TuanDanny/AW-Car/docs/README.md

# Tài liệu simplev1

- [Bản source ba board hiện hành](current-release.md).

- [Protocol](protocol.md): giao thức UART/SPI và hành vi điều khiển.
- [Nguồn tham khảo](upstream.md), [Brain](brain.md), [Dashboard](dashboard.md).
- [Build/nạp/log](build.md), [kết quả kiểm chứng](verification.md).
- [Mốc skeleton đã duyệt](skeleton-baseline.md), [câu nói/pinyin/dịch nghĩa](voice-commands.md).
- [AP+STA / OTA đã duyệt và cổng kiểm thử](ota-network-plan.md).
- [Dùng OTA và log hằng ngày](ota-usage.md).
- [Đo độ trễ bốn nút trên điện thoại](latency-measurement.md).
- [Kết quả92mẫu thật và giới hạn SPI](latency-results.md).
- [Review tối ưu, chưa thay firmware](optimization-review.md).
- [Bản tối ưu nhỏ và số đo A/B sau nạp Motion](optimization-results.md).
