TuanDanny/AW-Car/.github/README.md

# Automation

CI cho nhánh simplev1 độc lập. Gowin có giấy phép và thử board chạy trên máy local.
