TuanDanny/AW-Car/esp/README.md

# ESP32-S3 simplev1

`brain`: Xiaozhi/âm thanh/OLED, STA-only. `motion`: AP/Web, điều khiển và SPI.
`shared`: C++17 không phụ thuộc ESP-IDF, codec/lõi điều khiển kiểm trên host.
