TuanDanny/AW-Car/dashboard/README.md

# Web Dashboard

Dashboard HTML/CSS/ES modules thuần, cùng asset trên ESP32 và PC simulator.
Manual/AI, Cho phép/DỪNG/Xóa lỗi, sáu hướng, tốc độ, transcript/tool events và
telemetry có cờ hợp lệ. Không CDN/framework hoặc JSON đi thẳng xuống FPGA.
Contract: [Web-v1](web-brain-protocol.md).

## Dùng dashboard trên điện thoại

1. Nối Wi-Fi `AW-CAR`, mở `http://192.168.4.1` bằng Chrome hoặc Safari. Nhập PIN hiện
   trên OLED; giữ BOOT lâu để hiện lại. PIN dashboard khác mật khẩu Wi-Fi,
   đổi sau mỗi reset. Chỉ giữ một tab dashboard đang kết nối.
2. WS2812 onboard chỉ báo trạng thái; cụm điều khiển đèn và tool RGB demo
   đã xóa. Nút **Bắt đầu/kết thúc nghe** tương đương nhấn/nhả BOOT ngắn.
   Đợi trạng thái đang nghe rồi nói tiếng Trung; xem nhận dạng, trả lời và
   tool trong nhật ký. Ví dụ chào `你好`; tool xe còn phải đủ mode/quyền/context.
3. Manual dùng sáu nút giữ để lái, nhả về 0; mức tốc độ mặc định 30%.
   Chỉ mở khi **Cho phép** đã được Motion xác nhận. Khi chưa nối Motion,
   các nút lái khóa và telemetry ghi “Chưa có dữ liệu”.
4. Chọn AI trên dashboard rồi xin phép Motion để nhận hành động xe ngắn.
   Manual vẫn trò chuyện và nhận DỪNG. Đổi mode, DỪNG hoặc mất liên
   kết an toàn sẽ thu quyền; phải Cho phép lại. Quyền AI tối đa 5 phút.
5. **Xóa lỗi** chỉ sáng khi Motion báo FAULT còn mới và chưa có quyền chạy.
   Sau khi nguyên nhân đã hết, bấm để yêu cầu phục hồi; thành công vẫn phải
   **Cho phép** lại. Không nhả E-stop rồi tự ARM. Chưa ghép gate/motor thật.
6. Để Safari ở trước màn hình khi điều khiển Manual. Ẩn tab/khóa màn hình
   hoặc mất Web sẽ dừng và bỏ ARM. Reconnect không phát lại nút đang giữ.

Ngày03/11 đã thử thực trên iPhone Safari: đăng nhập và giữ WebSocket ổn định,
RGB và nút nghe trên dashboard được người dùng xác nhận hoạt động.
Chưa nghiệm thu lái xe vì chưa có Motion/gate/motor trong vòng thử này.

## Chạy giả lập

Từ root: Python3.13, Node và compiler host C++17 (`g++`/`clang++` hoặc `CXX`).
Windows có thể dùng LLVM-MinGW chính thức trong `build/toolchain/`; không
dùng cross-compiler Xtensa để tạo chương trình chạy trên PC.

```powershell
python -m venv .venv
.venv/Scripts/python.exe -m pip install -r dashboard/requirements-dev.lock
python tools/build_brain_host.py
.venv/Scripts/python.exe dashboard/simulator.py --port 8767
```

Lockfile dev chốt Python3.13 và các phiên bản đã kiểm thử trong review tích hợp;
aiohttp3.14.5 thay3.13.2 có advisory đã công bố. Đây là server/test PC, không
phải dependency runtime ESP32. Nâng lock phải audit và chạy lại Web regression.

Mở `http://127.0.0.1:8767`, mã **123456 chỉ cho simulator localhost**.
Firmware dùng SSID `AW-CAR`; mật khẩu AP giữ trong NVS hoặc đặt cố định
bằng `CONFIG_AWCAR_AP_PASSWORD` ở sdkconfig cục bộ. PIN dashboard vẫn sinh
mỗi boot; không dùng credentials simulator cho ESP32. Simulator không mô phỏng CPU, Wi-Fi/I²S/
FreeRTOS, PID, FPGA hay motor. Mỗi instance chỉ nhận một WebSocket.

```powershell
.venv/Scripts/python.exe -m unittest discover -s tests
node --test dashboard/control.test.mjs dashboard/connection.test.mjs
```

Thử tải bằng instance riêng, không giành kết nối với trình duyệt:

```powershell
.venv/Scripts/python.exe dashboard/simulator.py --port 8768
.venv/Scripts/python.exe tools/brain_soak.py --url http://127.0.0.1:8768 --seconds 1800 --report build/brain/soak.json
```

`/api/lab` chỉ có trong simulator để tiêm voice/mất mạng/tiến thời gian;
không có trong firmware. Soak dùng thời gian thực; test hạn5phút dùng đồng
hồ ảo riêng, không trộn thành số đo độ trễ thật. Trace Motion giữ256 frame,
sự kiện100, mẫu benchmark tối đa40.000.

## Brain thật + Motion PC test peer

Sau khi có bộ USB–UART **TTL3,3V**, nối Brain TX17→RX adapter,
RX18←TX adapter, GND chung. Không nối5V hoặc ngõ RS232 vào GPIO.
Giữ console/USB Brain riêng, chưa nối driver/motor.

```powershell
.venv/Scripts/python.exe tools/motion_serial_peer.py --port COM_ADAPTER
```

Peer chỉ xác thực BM-v1/lease, số đo tốc độ/pin invalid. Profile mặc định
`AWCAR_MOTION_IS_SIMULATED=y` để ghi nhãn giả lập. Brain đã được nạp ngày
03/11/2026, kiểm tra boot/AP+STA; chưa thử UART vật lý hoặc peer Motion.
Xem [bằng chứng](../docs/brain-dashboard-verification.md).

## Bổ sung ghép Motion 0.1

Core Motion mới ở `codex/esp32-s3-motion`, không thay PC peer mặc định ở đây.
Motion bản COM7 vẫn LOCKED; ngày04/11 đã ghép UART thật MotionTX13/RX14
với BrainRX18/TX17, chưa ghép FPGA/gate/motor. STATUS đo lại20,1Hz/age≤49ms;
không dùng Cho phép như bằng chứng motor sẽ chạy. Cấu hình
`AWCAR_MOTION_IS_SIMULATED` chỉ bỏ nhãn sau khi đã ghép và xác nhận dữ liệu
thật; profile đã nạp dùng `n`, mặc định PC peer vẫn `y`.
Xem [báo cáo UART hiện tại](../docs/brain-motion-final-link-report.json).
Computer use đã thử Xóa lỗi, giao diện hẹp và socket đóng; xem
[báo cáo bổ sung](../docs/brain-motion-clear-verification.md).

## Mốc 04/11: giao diện và chẩn đoán

Màn hình chính tập trung vào mode, Cho phép/DỪNG, hướng và tốc độ. Mở
Trạng thái xe/RGB/Trợ lý/Wi-Fi khi cần; AI tự mở hội thoại. Chẩn đoán mạng
nằm trong mục mở rộng. Không bỏ chức năng hoặc thay contract an toàn.
`connection.mjs` tách trạng thái kết nối/quyền cục bộ để test không cần DOM.
Simulator có `pause_status` (0–10.000 ms) và bộ đếm STOP chỉ để thử trạng
thái Degraded; không có endpoint này trên firmware.
Xem [báo cáo, phép đo và giới hạn phần cứng](../docs/brain-network-reliability.md).

## WS2812 báo trạng thái

Đã xóa UI/handler RGB thử nghiệm; không có lớp tương thích cho command đó.
`indicator` trong chẩn đoán là dữ liệu chỉ đọc: color/reason/known và bộ đếm
ghi/lỗi LED. Simulator cũng dùng policy C++ sản xuất, không tự dựng bộ chọn
màu bằng Python. Nút nghe, Manual/AI, sáu hướng và STOP giữ nguyên.
Xem [contract LED](../docs/status-led.md).

Trong mục Wi-Fi, badge xác nhận trạng thái STA thực (khởi tạo/kết nối/DHCP/
đã cóIP/thử lại), IP/RSSI và lý do lỗi/countdown khi có. Trạng thái Xiaozhi
được tách riêng: nối Wi-Fi chưa chứng minh cloud đã nối. Khi mất STATUS/WS,
giao diện không giữ nhãn xanh cũ. Lưu cấu hình chỉ báo đã nhận yêu cầu; chờ
STATUS xác nhận. Mạng được chọn làm mặc định cho lần boot sau kể cả đã lưu
ở vị trí khác; không phải chỉ cập nhật mật khẩu rồi vẫn chọn mạng cũ.
