TuanDanny/AW-Car/esp/shared/README.md

# Lõi dùng chung

Contract ở `../../docs/protocol.md`. Code C++17, không driver/FreeRTOS/heap trên
đường điều khiển. Hai firmware include thư mục này; host test dùng cùng source.
