TuanDanny/AW-Car/fpga/targets/README.md

# Target board

[Tang Nano9K](tang_nano9k/README.md) là target simplev1 duy nhất: shell POR,
CST, SDC và Tcl build bằng Gowin. RTL chức năng dùng chung ở `../rtl`.
