TuanDanny/AW-Car/esp/brain/main/README.md

# Brain application

Application Xiaozhi v2.5.2 được giữ cho activation, audio và giao thức cloud.
Profile cố định ở `boards/aw-car`; UART/MCP context ở `car`. CMake liệt kê
tường minh các nguồn cần dùng; không quét hay nhập các board upstream khác.
