TuanDanny/AW-Car/esp/shared/src/README.md

# Implementation

Codec và Control dùng chung giữa ESP32 và host simulator/test, không cấp phát heap.
