TuanDanny/AW-Car/esp/brain/main/boards/README.md

# Board cố định

Chỉ `aw-car` được build. `common` giữ interface Board và BOOT upstream;
không có bộ chọn hàng trăm board hoặc modem.
