TuanDanny/AW-Car/esp/brain/main/display/README.md

# OLED display

Chỉ SSD1306 128×64/LVGL; giữ font Trung và dynamic glyph upstream.
Không nhập LCD màu, e-paper, JPEG, GIF hoặc assets board khác.
