TuanDanny/AW-Car/esp/brain/main/led/README.md

# LED interface

Interface Led upstream; pixel WS2812 thật nằm ở `boards/aw-car/status_led`.
Không đăng ký tool RGB.
