TuanDanny/AW-Car/esp/shared/include/simple/README.md

# API C++

`protocol.hpp`: UART/SPI và các kiểu dùng chung. `control.hpp`: phân xử Manual/AI,
deadline, đổi chiều và wake driver. Một task sở hữu, thời gian truyền từ caller.
