TuanDanny/AW-Car/firmware/brain/docs/v0/README.md

# Xiaozhi: docs/v0

Thành phần từ Xiaozhi v2.5.2, commit 49b4380b3faa0ceadd28a3e78aaf0f311c46c57e.
Giữ để build và đối chiếu bản stock; phần cứng AW-Car chưa nghiệm thu.

Nội dung trực tiếp trong thư mục:

- `AtomMatrix-echo-base.jpg`
- `atoms3r-echo-base.jpg`
- `ESP32-BreadBoard.jpg`
- `esp32s3-box3.jpg`
- `lichuang-s3.jpg`
- `m5stack-cores3.jpg`
- `magiclick-2p4.jpg`
- `waveshare-esp32-s3-touch-amoled-1.8.jpg`
- `wiring.jpg`
