TuanDanny/AW-Car/firmware/brain/main/boards/README.md

# Xiaozhi: main/boards

Thành phần từ Xiaozhi v2.5.2, commit 49b4380b3faa0ceadd28a3e78aaf0f311c46c57e.
Giữ để build và đối chiếu bản stock; phần cứng AW-Car chưa nghiệm thu.

Nội dung trực tiếp trong thư mục:

- [aw-car-ai-rgb](aw-car-ai-rgb/README.md): demo F03 điều khiển RGB qua MCP.
- `alientek/`
- `bread-compact-esp32/`
- `bread-compact-esp32-lcd/`
- `bread-compact-ml307/`
- `bread-compact-nt26/`
- `bread-compact-wifi/`
- `bread-compact-wifi-lcd/`
- `bread-compact-wifi-s3cam/`
- `chd/`
- `common/`
- `dfrobot/`
- `doit-s3-aibox/`
- `du-chatx/`
- `electron-bot/`
- `espressif/`
- `folotoy/`
- `freenove-esp32s3-display-2.8-lcd/`
- `genjutech-s3-1.54tft/`
- `guition/`
- `hu-087/`
- `jiuchuan-s3/`
- `kevin/`
- `labplus/`
- `lc-s3-wifi-1.54tft/`
- `lcdwiki-es3c35p/`
- `lceda-course-examples/`
- `lckfb/`
- `lilygo/`
- `m5stack/`
- `magiclick/`
- `maza-ai/`
- `minsi-k08-dual/`
- `mixgo-nova/`
- `movecall/`
- `nologo/`
- `nulllab-ai-vox-v3/`
- `otto-robot/`
- `quandong-s3-dev/`
- `rymcu/`
- `sensecap-watcher/`
- `spotpear/`
- `surfer-c3-1.14tft/`
- `taiji-pi-s3/`
- `waveshare/`
- `wdmomo/`
- `wk-esp32s3-dev/`
- `xmini/`
- `xorigin/`
- `yunliao-s3/`
- `zectrix/`
- `zhengchen/`
