TuanDanny/AW-Car/esp/brain/main/audio/codecs/README.md

# I²S codec

`NoAudioCodecSimplex` upstream điều khiển I²S thật, tách mic và loa.
Các codec I²C/board khác đã được bỏ.
