TuanDanny/AW-Car/esp/brain/main/audio/engines/README.md

# ESP-SR engine

Engine AFE stock Xiaozhi cho ESP32-S3, xử lý audio16kHz và VAD chuẩn.
Không thêm lớp phân xử VAD riêng cho xe.
