TuanDanny/AW-Car/esp/brain/main/boards/common/README.md

# Board interfaces

Interface Board, nút BOOT và các header interface phụ được giữ từ Xiaozhi
v2.5.2. Không build WifiBoard provisioning, modem, camera, pin hoặc PWM.
