TuanDanny/AW-Car/firmware/brain/main/boards/bread-compact-esp32/README.md

# 编译配置命令

**配置编译目标为 ESP32：**

```bash
idf.py set-target esp32
```

**打开 menuconfig：**

```bash
idf.py menuconfig
```

**选择板子：**

```
Xiaozhi Assistant -> Board Type -> 面包板 ESP32 DevKit
```

**编译：**

```bash
idf.py build
```
