TuanDanny/AW-Car/firmware/brain/main/boards/bread-compact-wifi-lcd/README.md

# Xiaozhi: main/boards/bread-compact-wifi-lcd

Thành phần từ Xiaozhi v2.5.2, commit 49b4380b3faa0ceadd28a3e78aaf0f311c46c57e.
Giữ để build và đối chiếu bản stock; phần cứng AW-Car chưa nghiệm thu.

Nội dung trực tiếp trong thư mục:

- `compact_wifi_board_lcd.cc`
- `config.h`
- `config.json`
