TuanDanny/AW-Car/firmware/brain/main/boards/surfer-c3-1.14tft/README.md

## Surfer-ESP32-C3 开发板

1、参考立创·实战派C3-ESP32C3开发板，修改了TFT屏幕背光引脚，增加ADC电池电量检测功能;
2、该开发板 flash 大小为 16MB，编译时注意选择默认的分区表。
