TuanDanny/AW-Car/firmware/brain/main/boards/zhengchen/README.md

# Xiaozhi: main/boards/zhengchen

Thành phần từ Xiaozhi v2.5.2, commit 49b4380b3faa0ceadd28a3e78aaf0f311c46c57e.
Giữ để build và đối chiếu bản stock; phần cứng AW-Car chưa nghiệm thu.

Nội dung trực tiếp trong thư mục:

- `1.54tft-ml307/`
- `1.54tft-wifi/`
- `cam/`
- `cam-ml307/`
