TuanDanny/AW-Car/firmware/brain/main/boards/zectrix/zectrix-s3-epaper-4.2/README.md

# Xiaozhi: main/boards/zectrix/zectrix-s3-epaper-4.2

Thành phần từ Xiaozhi v2.5.2, commit 49b4380b3faa0ceadd28a3e78aaf0f311c46c57e.
Giữ để build và đối chiếu bản stock; phần cứng AW-Car chưa nghiệm thu.

Nội dung trực tiếp trong thư mục:

- `board_power_bsp.cc`
- `board_power_bsp.h`
- `charge_status.cc`
- `charge_status.h`
- `config.h`
- `config.json`
- `custom_lcd_display.cc`
- `custom_lcd_display.h`
- `i2c_power_hook.cc`
- `rtc_pcf8563.cc`
- `rtc_pcf8563.h`
- `sleep_manager_compat.h`
- `zectrix-s3-epaper-4.2.cc`
- `zectrix_nfc.cc`
- `zectrix_nfc.h`
