TuanDanny/AW-Car/firmware/brain/main/boards/alientek/atk-dnesp32s3m-wifi/README.md

# Xiaozhi: main/boards/alientek/atk-dnesp32s3m-wifi

Thành phần từ Xiaozhi v2.5.2, commit 49b4380b3faa0ceadd28a3e78aaf0f311c46c57e.
Giữ để build và đối chiếu bản stock; phần cứng AW-Car chưa nghiệm thu.

Nội dung trực tiếp trong thư mục:

- `atk_dnesp32s3m.cc`
- `config.h`
- `config.json`
