TuanDanny/AW-Car/firmware/brain/main/boards/espressif/esp-sparkbot/README.md

# Xiaozhi: main/boards/espressif/esp-sparkbot

Thành phần từ Xiaozhi v2.5.2, commit 49b4380b3faa0ceadd28a3e78aaf0f311c46c57e.
Giữ để build và đối chiếu bản stock; phần cứng AW-Car chưa nghiệm thu.

Nội dung trực tiếp trong thư mục:

- `config.h`
- `config.json`
- `esp_sparkbot_board.cc`
