TuanDanny/AW-Car/firmware/brain/main/boards/espressif/esp32-s3-korvo-2-v3.0-rndis/README.md

# Xiaozhi: main/boards/espressif/esp32-s3-korvo-2-v3.0-rndis

Thành phần từ Xiaozhi v2.5.2, commit 49b4380b3faa0ceadd28a3e78aaf0f311c46c57e.
Giữ để build và đối chiếu bản stock; phần cứng AW-Car chưa nghiệm thu.

Nội dung trực tiếp trong thư mục:

- `config.h`
- `config.json`
- `esp32s3_korvo2_v3_board.cc`
- `power_manager.h`
