TuanDanny/AW-Car/firmware/brain/main/boards/m5stack/atommatrix-echo-base/README.md

# 编译配置命令

**配置编译目标为 ESP32：**

```bash
idf.py set-target esp32
```

**打开 menuconfig：**

```bash
idf.py menuconfig
```

**选择板子：**

```
Xiaozhi Assistant -> Board Type -> AtomMatrix + Echo Base
```

**编译：**

```bash
idf.py build
```
