TuanDanny/AW-Car/firmware/brain/main/boards/waveshare/esp32-p4-wifi6-touch-lcd-3.5/README.md

# Waveshare ESP32-P4-WIFI6-Touch-LCD-3.5

**ESP32-P4-WIFI6-Touch-LCD-3.5** is the ESP32-P4 +ESP32-C6 screen development board launched by waveshare.

## Configuration

Configuration in `menuconfig`.

Selection Board Type `Xiaozhi Assistant --> Board Type`
- Waveshare ESP32-P4-WIFI6-Touch-LCD-3.5
