TuanDanny/AW-Car/firmware/brain/main/boards/waveshare/esp32-s3-cam/README.md

新增 微雪 开发板: ESP32-S3-CAM-XXXX
产品链接：
https://www.waveshare.net/shop/ESP32-S3-CAM-OV5640.htm
https://www.waveshare.net/shop/ESP32-S3-CAM-OV3660.htm
https://www.waveshare.net/shop/ESP32-S3-CAM-GC2145.htm
https://www.waveshare.net/shop/ESP32-S3-CAM-GC0308.htm
