TuanDanny/AW-Car/.githooks/README.md

# Hooks simplev1

Kiểm cấu trúc trước commit, kiểm native trước push. Không bỏ hook để che lỗi.
