TuanDanny/AW-Car/esp/brain/scripts/README.md

# Build assets

Hai script upstream: sinh header locale và đóng gói font/assets.
Không gọi flash, monitor hoặc cổng serial.
