TuanDanny/AW-Car/esp/shared/include/README.md

# Public headers

Thư mục `simple` chứa các kiểu/codec/lõi điều khiển không phụ thuộc SDK.
