TuanDanny/AW-Car/esp/brain/main/assets/README.md

# Built-in assets

Chỉ âm báo chung và tiếng Trung từ upstream. Font Trung được đóng gói
vào `generated_assets.bin` từ dependency xiaozhi-fonts đã khóa phiên bản.
`lang_config.h` là file sinh, không commit.
