TuanDanny/AW-Car/esp/brain/main/audio/README.md

# Stock audio pipeline

AudioService, Opus, I²S simplex và ESP-SR AFE của Xiaozhi v2.5.2. Chỉ
NoAudioCodecSimplex được dùng với INMP441/MAX98357A; tên upstream này
chỉ module I²S không có codec điều khiển, không phải âm thanh giả.
Không có CarChat/VAD guard bổ sung. Wake word không được bật trong profile.
