TuanDanny/AW-Car/esp/brain/main/notify/README.md

# Xiaozhi notifications

NotifyPlayer stock phát URL audio và subtitle qua AudioService. Không có
quyền điều khiển Motion.
