TuanDanny/AW-Car/esp/brain/main/assets/common/README.md

# Common sounds

Các âm báo Ogg upstream được Application/AudioService sử dụng.
