TuanDanny/AW-Car/esp/brain/main/assets/locales/README.md

# Locale

Chỉ giữ zh-CN cho profile được duyệt.
