TuanDanny/AW-Car/esp/brain/main/audio/demuxer/README.md

# Ogg audio

Ogg demuxer upstream phục vụ âm thanh activation/notification và gói Opus.
