TuanDanny/AW-Car/esp/brain/main/audio/wake_words/README.md

# Stock AFE support

Các lớp CustomWakeWord/cache được engine AFE upstream tham chiếu.
Profile không đóng gói mô hình WakeNet/MultiNet, không tự khởi động phiên lái.
