TuanDanny/AW-Car/esp/brain/main/display/lvgl_display/README.md

# LVGL text support

Font, theme tối, text/glyph cache và image interface mà OLED/Assets dùng.
Snapshot JPEG và điều khiển GUI từ cloud không bật trong profile.
