TuanDanny/AW-Car/firmware/brain/main/assets/locales/README.md

# Xiaozhi: main/assets/locales

Thành phần từ Xiaozhi v2.5.2, commit 49b4380b3faa0ceadd28a3e78aaf0f311c46c57e.
Giữ để build và đối chiếu bản stock; phần cứng AW-Car chưa nghiệm thu.

Nội dung trực tiếp trong thư mục:

- `ar-SA/`
- `bg-BG/`
- `ca-ES/`
- `cs-CZ/`
- `da-DK/`
- `de-DE/`
- `el-GR/`
- `en-US/`
- `es-ES/`
- `fa-IR/`
- `fi-FI/`
- `fil-PH/`
- `fr-FR/`
- `he-IL/`
- `hi-IN/`
- `hr-HR/`
- `hu-HU/`
- `id-ID/`
- `it-IT/`
- `ja-JP/`
- `ko-KR/`
- `mr-IN/`
- `ms-MY/`
- `nb-NO/`
- `nl-NL/`
- `pl-PL/`
- `pt-BR/`
- `pt-PT/`
- `ro-RO/`
- `ru-RU/`
- `sk-SK/`
- `sl-SI/`
- `sr-RS/`
- `sv-SE/`
- `th-TH/`
- `tr-TR/`
- `uk-UA/`
- `vi-VN/`
- `zh-CN/`
- `zh-TW/`
