TuanDanny/AW-Car/firmware/brain/main/audio/codecs/README.md

# Xiaozhi: main/audio/codecs

Thành phần từ Xiaozhi v2.5.2, commit 49b4380b3faa0ceadd28a3e78aaf0f311c46c57e.
Giữ để build và đối chiếu bản stock; phần cứng AW-Car chưa nghiệm thu.

Nội dung trực tiếp trong thư mục:

- `box_audio_codec.cc`
- `box_audio_codec.h`
- `dummy_audio_codec.cc`
- `dummy_audio_codec.h`
- `es8311_audio_codec.cc`
- `es8311_audio_codec.h`
- `es8374_audio_codec.cc`
- `es8374_audio_codec.h`
- `es8388_audio_codec.cc`
- `es8388_audio_codec.h`
- `es8389_audio_codec.cc`
- `es8389_audio_codec.h`
- `no_audio_codec.cc`
- `no_audio_codec.h`
