TuanDanny/AW-Car/esp/brain/main/assets/locales/zh-CN/README.md

# 简体中文

Bản dịch và âm thanh activation zh-CN từ Xiaozhi v2.5.2.
