TuanDanny/AW-Car/firmware/brain/main/assets/locales/bg-BG/README.md

# Xiaozhi: main/assets/locales/bg-BG

Thành phần từ Xiaozhi v2.5.2, commit 49b4380b3faa0ceadd28a3e78aaf0f311c46c57e.
Giữ để build và đối chiếu bản stock; phần cứng AW-Car chưa nghiệm thu.

Nội dung trực tiếp trong thư mục:

- `0.ogg`
- `1.ogg`
- `2.ogg`
- `3.ogg`
- `4.ogg`
- `5.ogg`
- `6.ogg`
- `7.ogg`
- `8.ogg`
- `9.ogg`
- `activation.ogg`
- `err_pin.ogg`
- `err_reg.ogg`
- `language.json`
- `upgrade.ogg`
- `welcome.ogg`
- `wificonfig.ogg`
