TuanDanny/AW-Car/docs/brain-dashboard-desktop.png

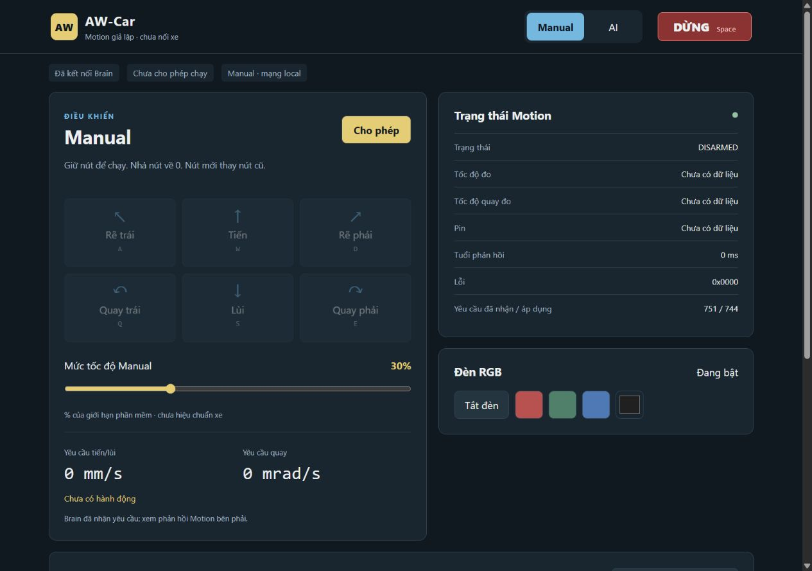
docs/brain-dashboard-desktop.png
