TuanDanny/AW-Car/docs/brain-network-degraded.png

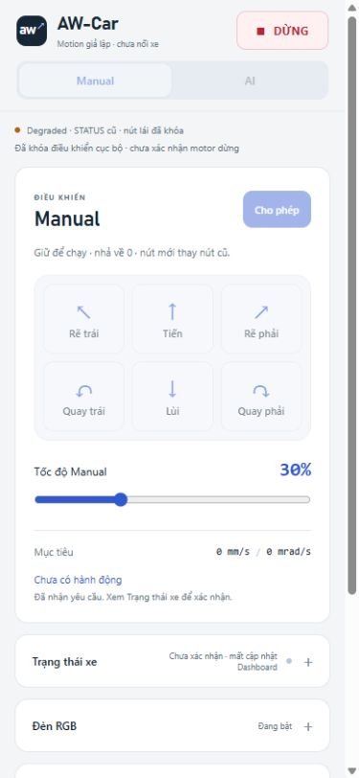
docs/brain-network-degraded.png
