TuanDanny/AW-Car/docs/status-led-dashboard.png

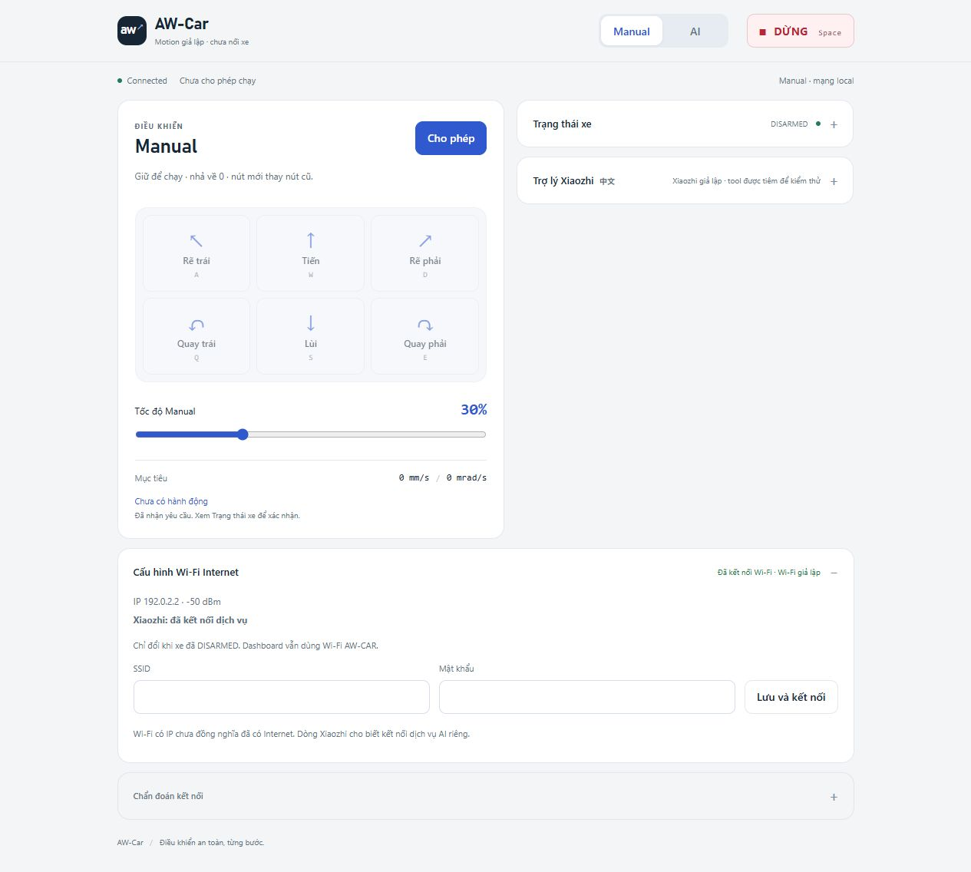
docs/status-led-dashboard.png
