TuanDanny/AW-Car/schematic/simplev1-preview.png

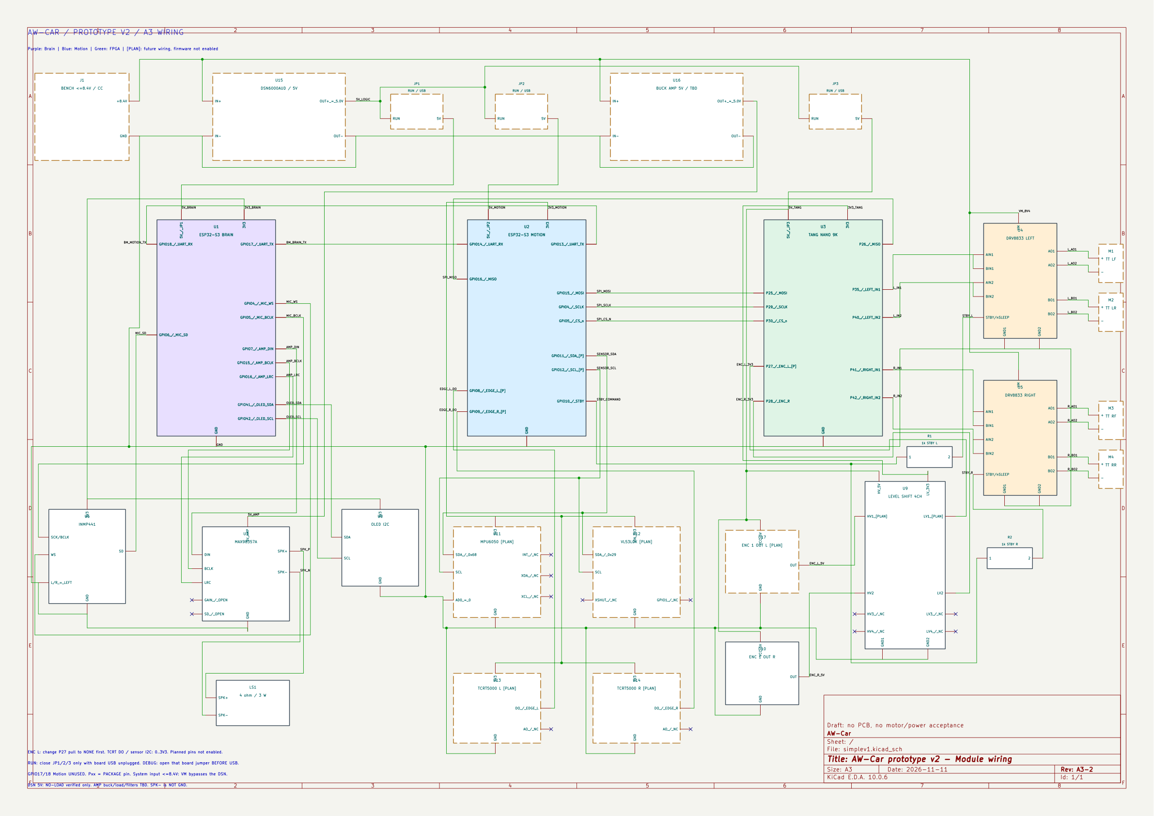
schematic/simplev1-preview.png
