TuanDanny/AW-Car/esp/brain/components/xiaozhi_network/README.md

# Xiaozhi ESP network transport

Phần ESP từ78/esp-ml3073.7.6, commit bf62ab3daf30965c18cde113e6c93df3cada6363
(Apache-2.0; giữ LICENSE). Chỉ HTTP client/TCP/TLS/MQTT/UDP/WebSocket;
không nhập AT modem/UART UHCI/cellular. MQTT registry được khóa trong manifest.
