TuanDanny/AW-Car/esp/brain/components/xiaozhi_network/src/README.md

# Network implementation

HTTP/WebSocket/NetworkError stock; transport socket ESP nằm trong `esp`.
