TuanDanny/AW-Car/esp/brain/components/xiaozhi_network/src/esp/README.md

# ESP socket transports

TLS dùng certificate bundle; HTTP/MQTT/UDP/WebSocket là triển khai thật từ
component đã được dùng trong baseline Brain. Không thêm HTTP server.
