TuanDanny/AW-Car/esp/brain/components/README.md

# Narrow third-party imports

`xiaozhi_network`: phần transport ESP/TLS từ78/esp-ml307, không modem.
`ssid_store`: SsidManager từ78/esp-wifi-connect, không AP/HTTP provisioning.
Mỗi phần giữ LICENSE; các dependency registry có lockfile và LICENSE riêng.
