TuanDanny/AW-Car/esp/brain/components/ssid_store/README.md

# SsidManager

Nhập từ78/esp-wifi-connect3.3.1 (MIT), giữ LICENSE. Dùng đúng namespace
`wifi` và keys ssid/password/channel, suffix1..9. Bổ sung kiểm tra lỗi lưu,
ưu tiên SSID vừa nhận; không xóa namespace activation hoặc cấu hình audio.
