TuanDanny/AW-Car/esp/brain/components/ssid_store/include/README.md

# SSID store interface

Header SsidManager upstream với AddSsid trả kết quả lưu NVS.
