TuanDanny/AW-Car/(list of files, drawings)

Other design files:
data/schematic-verification.json
