TuanDanny/AW-Car/schematic/simplev1.kicad_sch

## KiCad design schematic/simplev1.kicad_sch (2026-11-11)

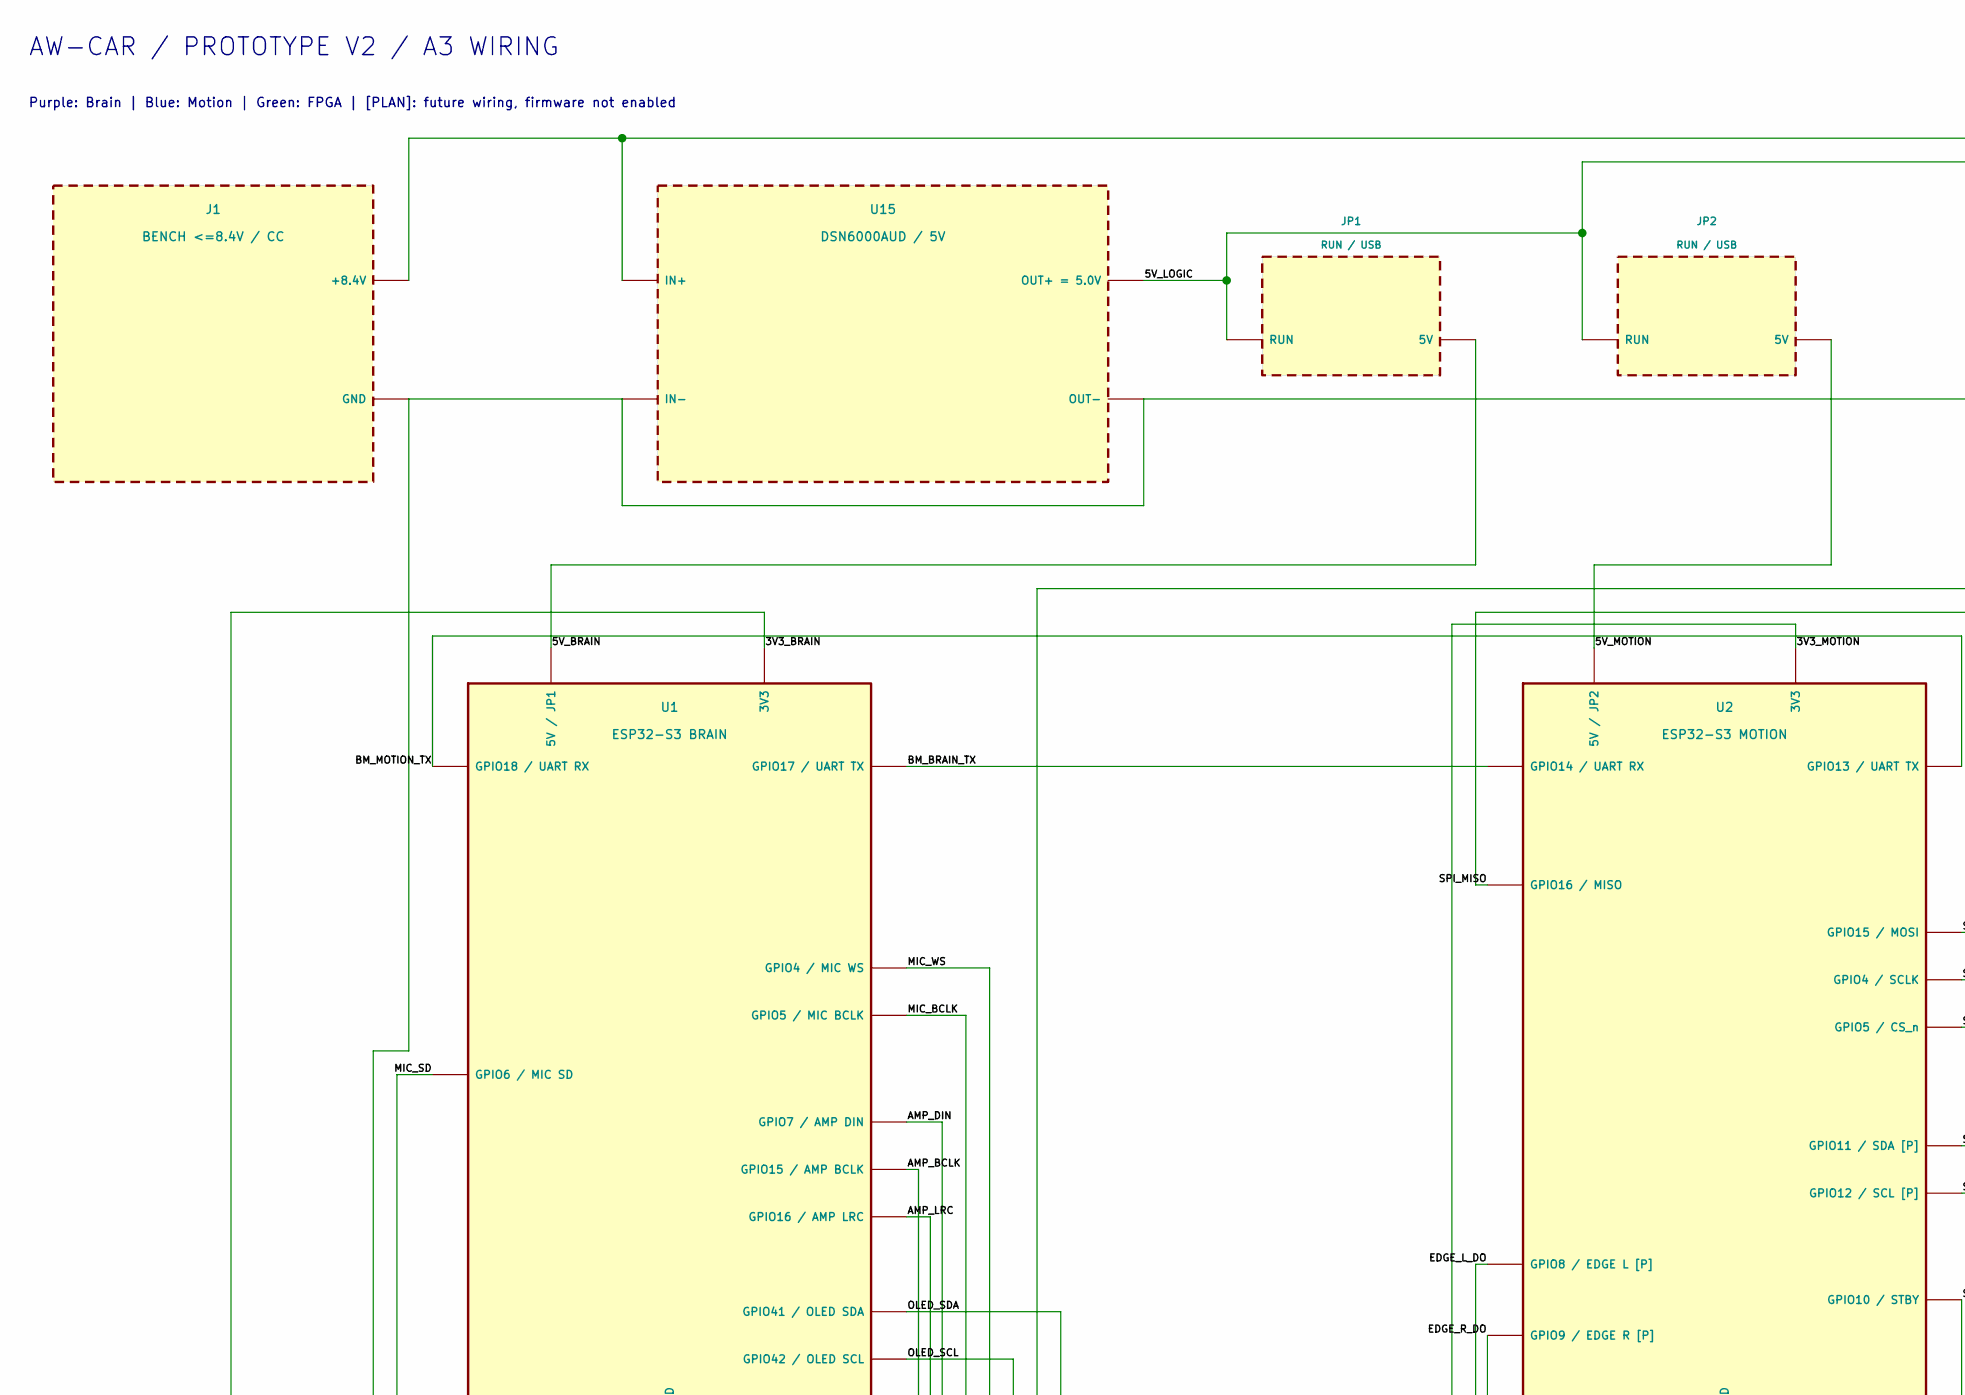
[picture p5: schematic simplev1.kicad_sch, part in row 1, column 1]

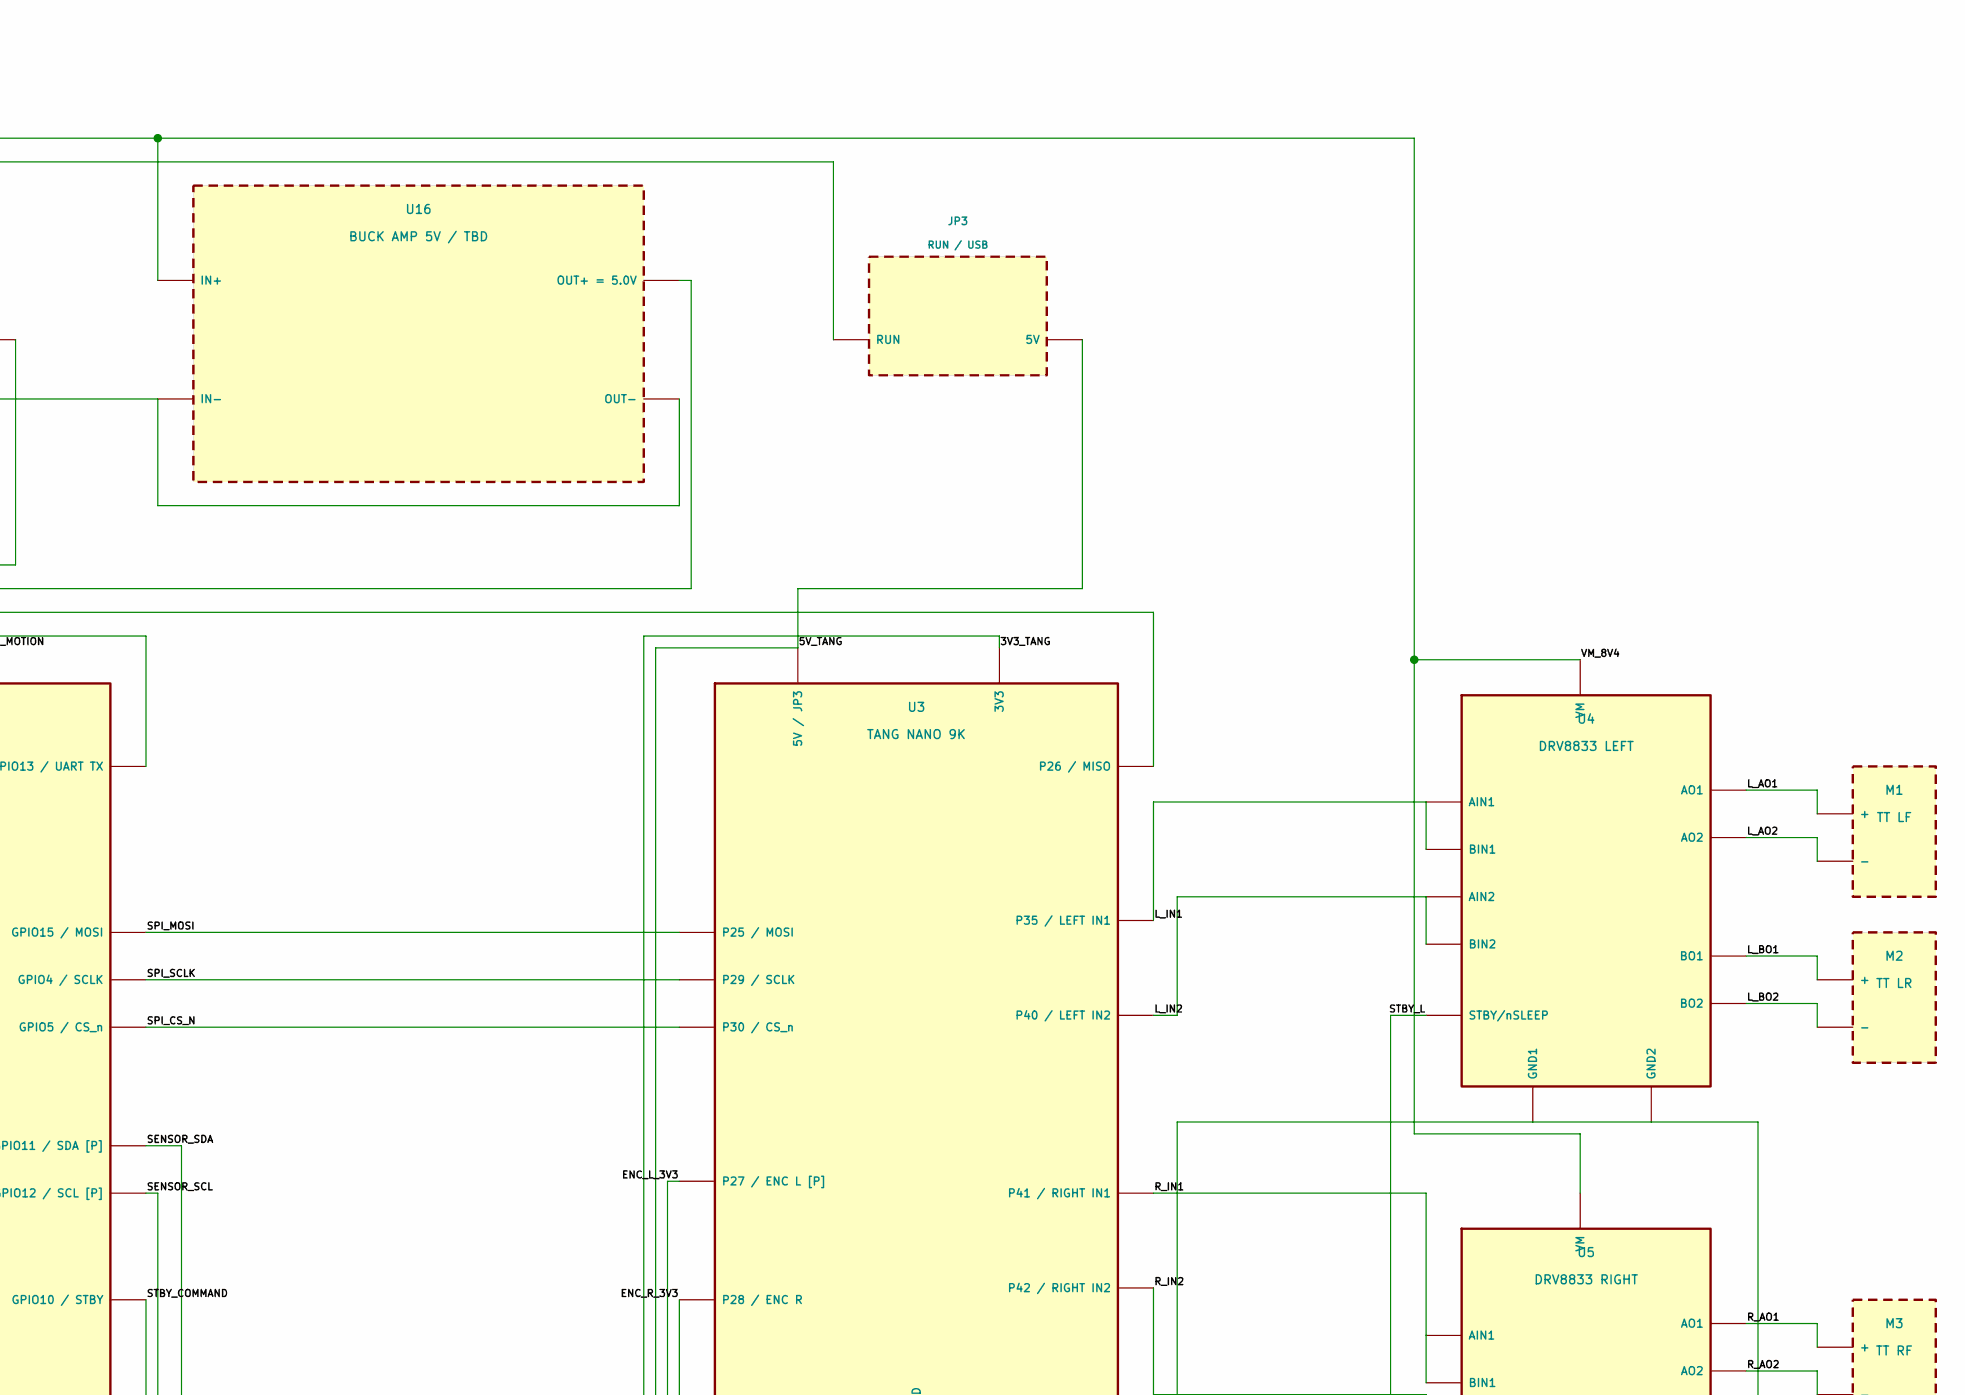
[picture p6: schematic simplev1.kicad_sch, part in row 1, column 2]

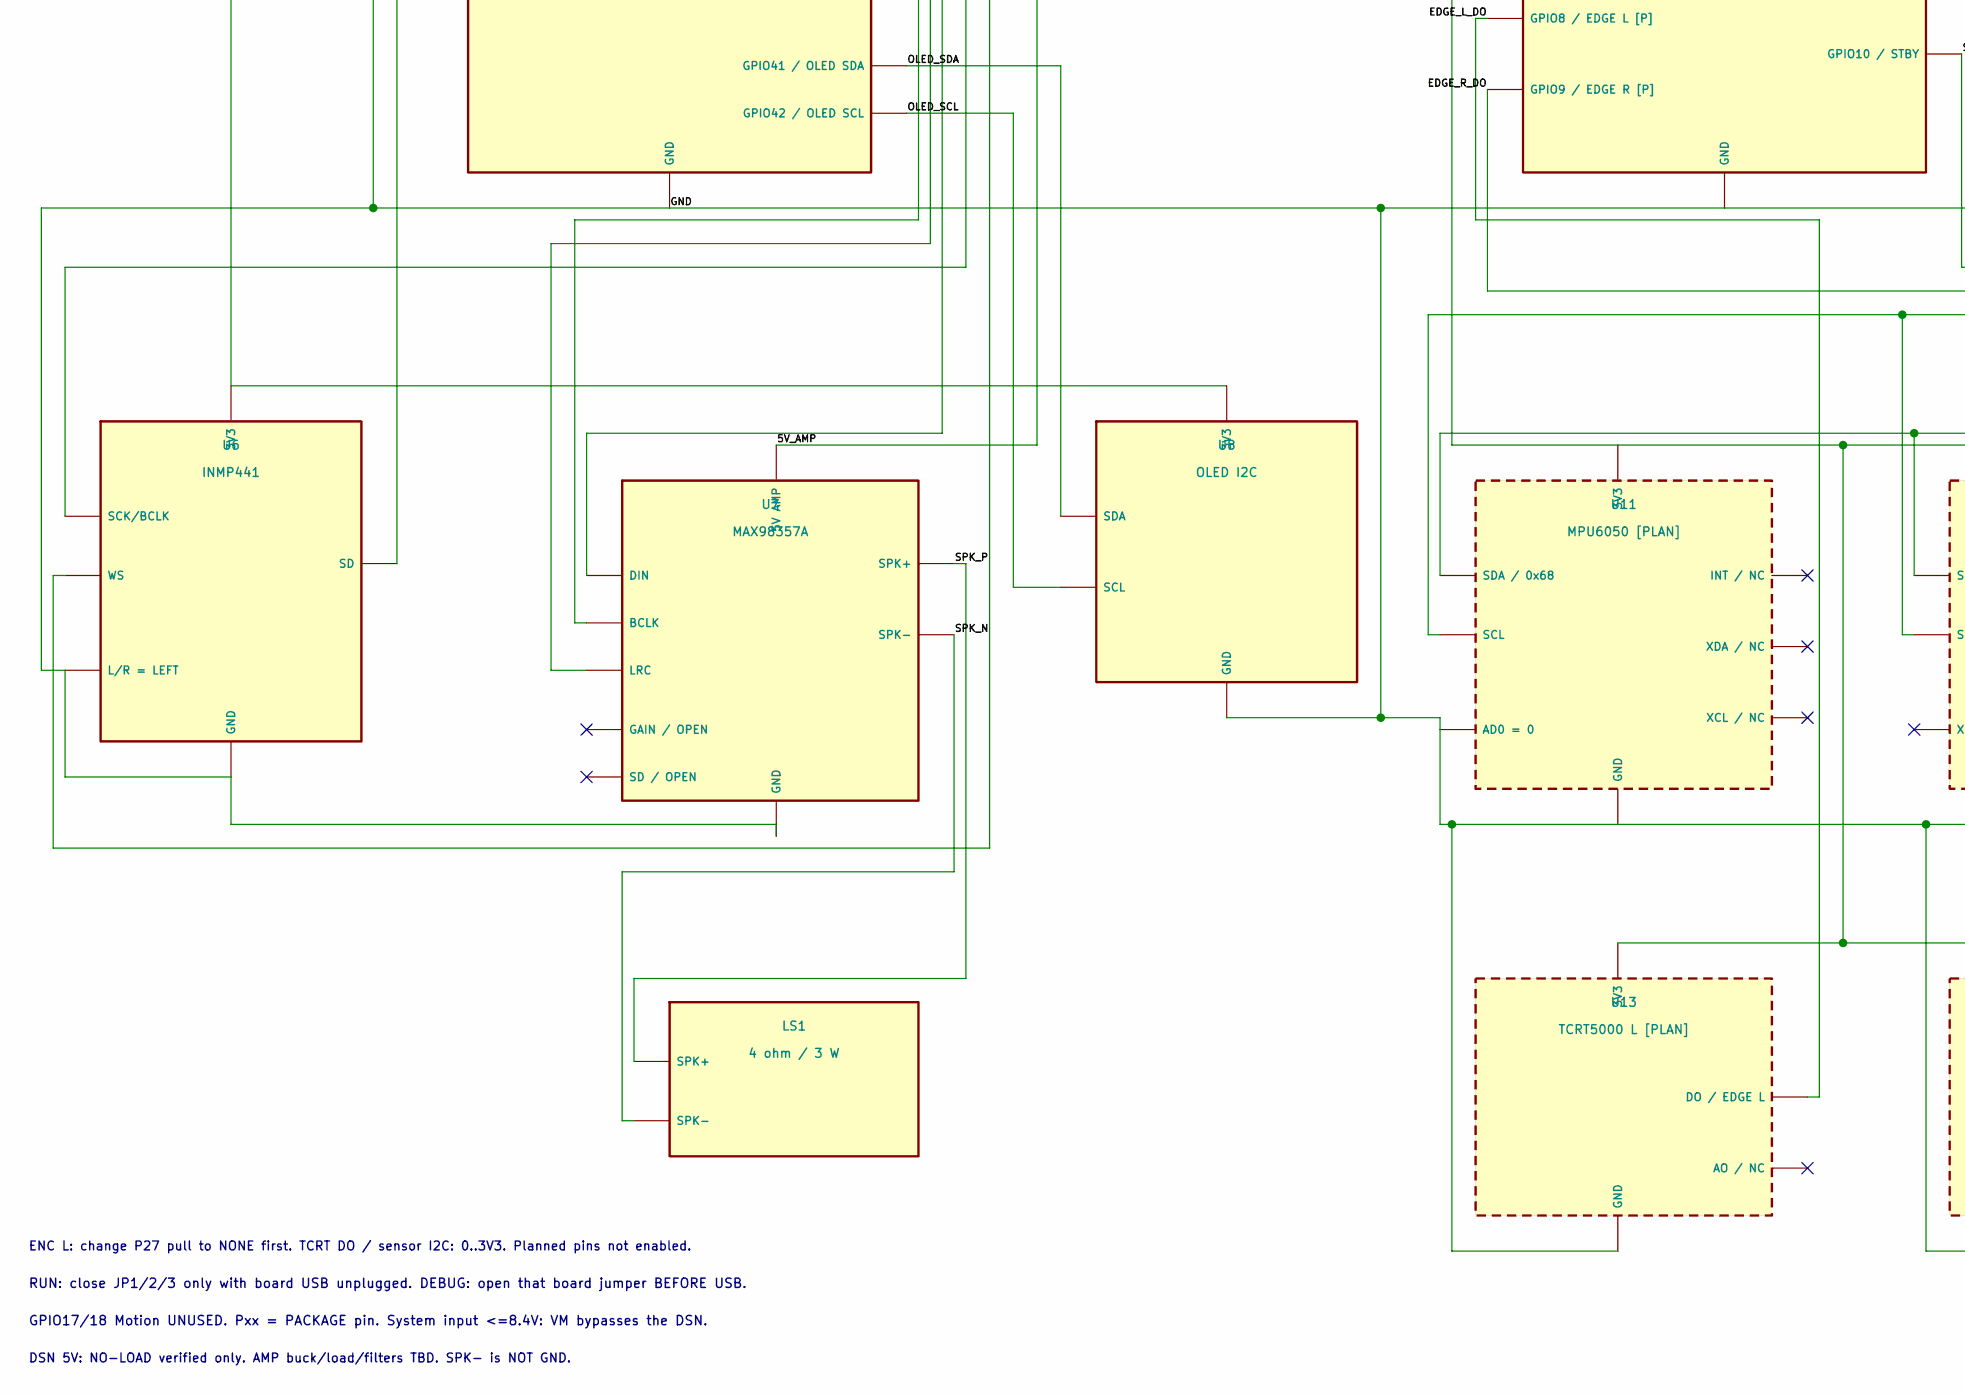
[picture p7: schematic simplev1.kicad_sch, part in row 2, column 1]

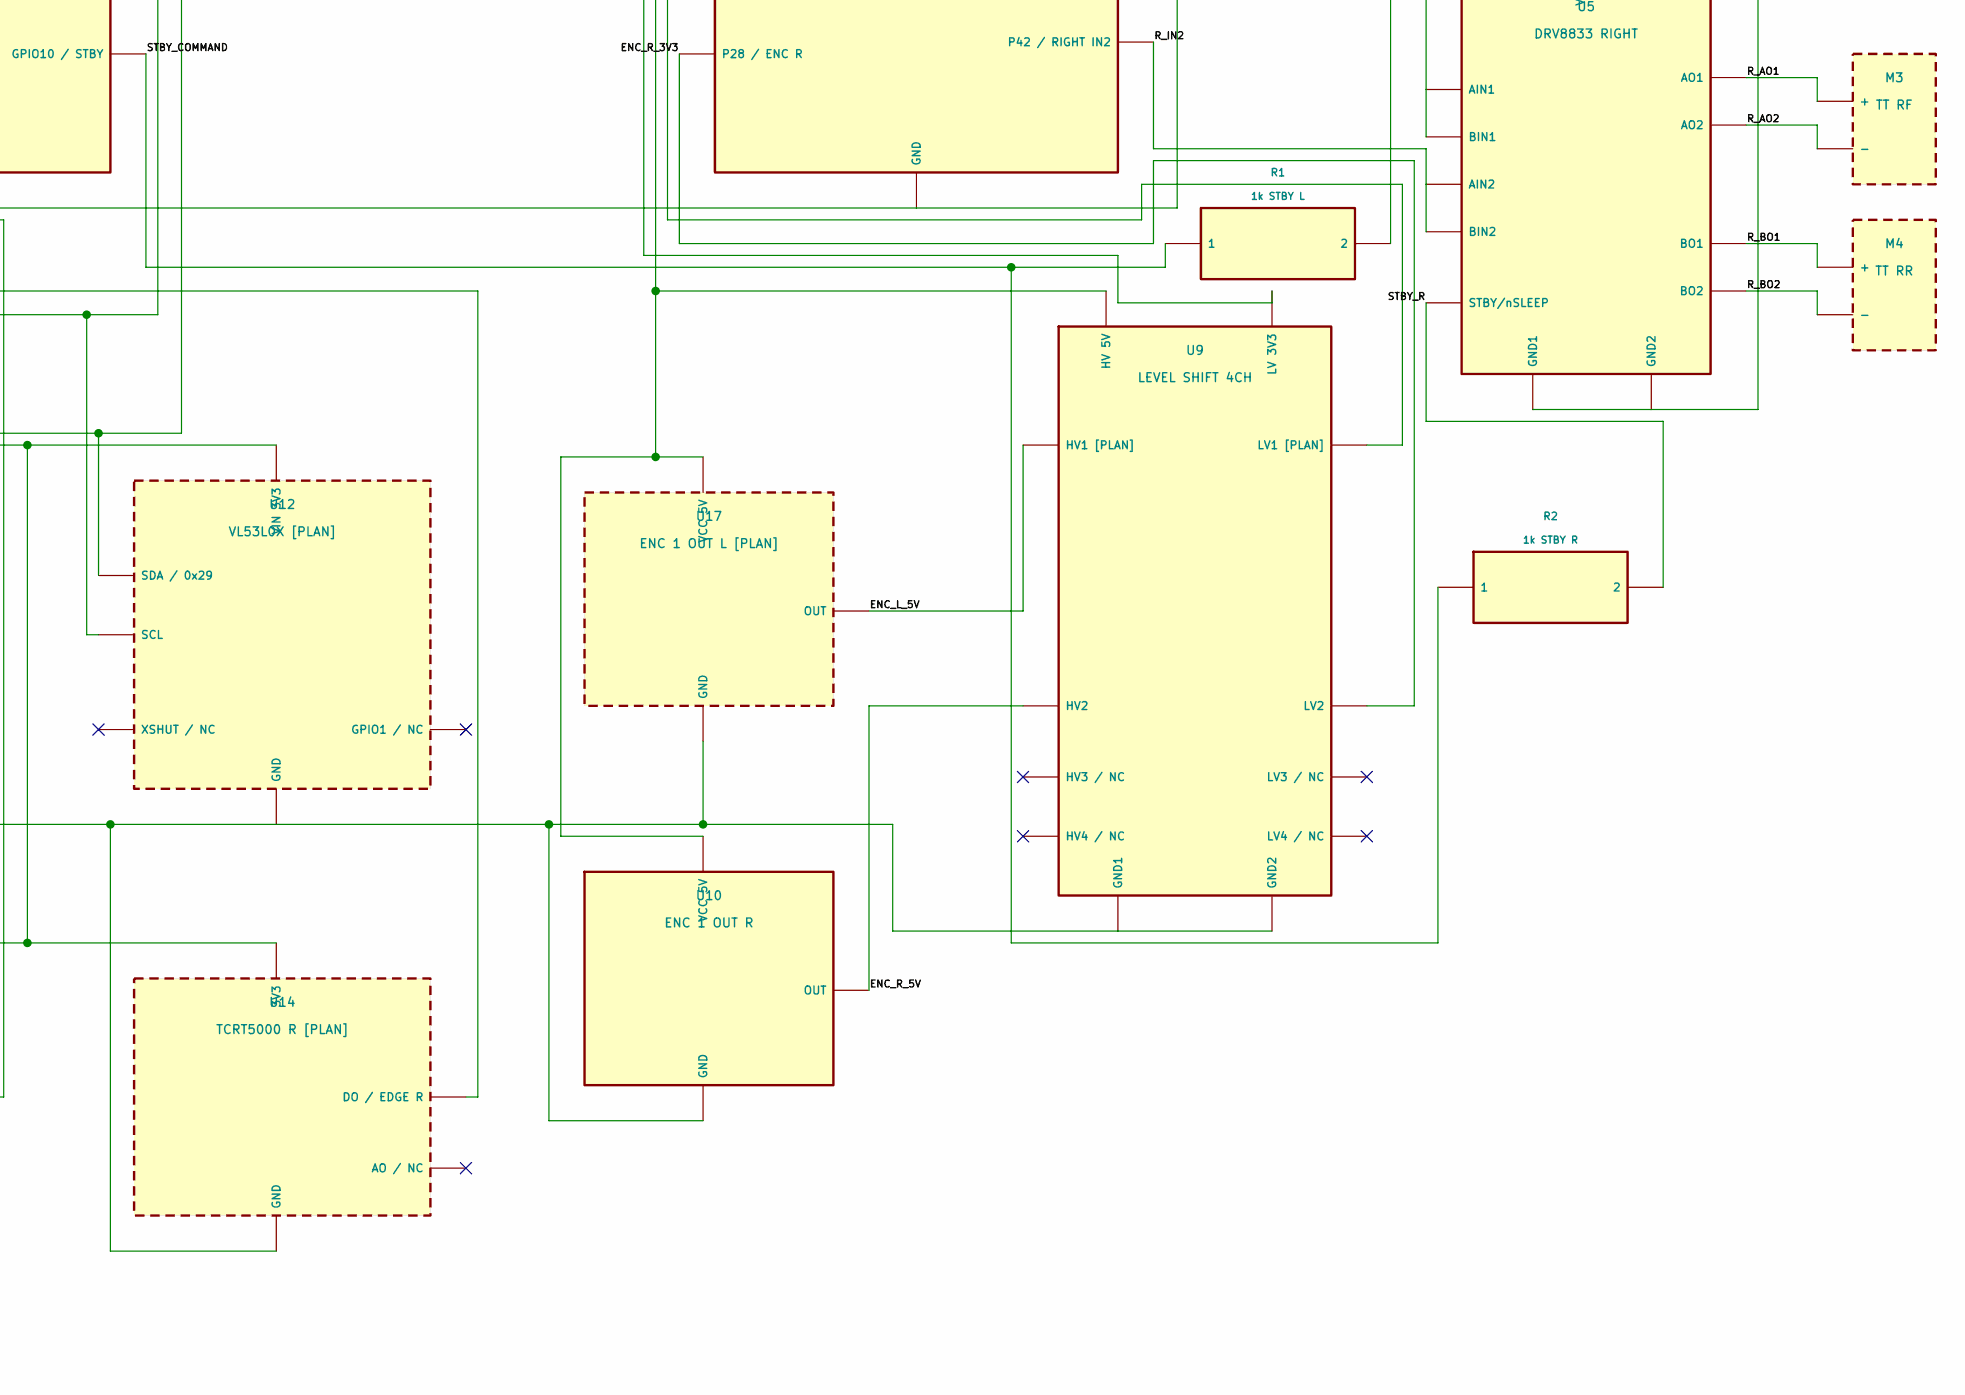
[picture p8: schematic simplev1.kicad_sch, part in row 2, column 2]

Parts:
J1: BENCH <=8.4V / CC
JP1, JP2, JP3: RUN / USB
LS1: 4 ohm / 3 W
M1: TT LF
M2: TT LR
M3: TT RF
M4: TT RR
R1: 1k STBY L
R2: 1k STBY R
U1: ESP32-S3 BRAIN
U2: ESP32-S3 MOTION
U3: TANG NANO 9K
U4: DRV8833 LEFT
U5: DRV8833 RIGHT
U6: INMP441
U7: MAX98357A
U8: OLED I2C
U9: LEVEL SHIFT 4CH
U10: ENC 1 OUT R
U11: MPU6050 [PLAN]
U12: VL53L0X [PLAN]
U13: TCRT5000 L [PLAN]
U14: TCRT5000 R [PLAN]
U15: DSN6000AUD / 5V
U16: BUCK AMP 5V / TBD
U17: ENC 1 OUT L [PLAN]

Connections:
3V3_BRAIN: U1.3V3, U6.VDD (3V3), U8.VCC (3V3)
3V3_MOTION: U2.3V3, U11.VCC (3V3), U12.VCC (VIN 3V3), U13.VCC (3V3), U14.VCC (3V3)
3V3_TANG: U3.3V3, U9.LV (LV 3V3)
5V_AMP: U7.VCC (5V AMP), U16.OUT+ (OUT+ = 5.0V)
5V_BRAIN: JP1.2 (5V), U1.5V (5V / JP1)
5V_LOGIC: JP1.1 (RUN), JP2.1 (RUN), JP3.1 (RUN), U15.OUT+ (OUT+ = 5.0V)
5V_MOTION: JP2.2 (5V), U2.5V (5V / JP2)
5V_TANG: JP3.2 (5V), U3.5V (5V / JP3), U9.HV (HV 5V), U10.VCC (VCC 5V), U17.VCC (VCC 5V)
AMP_BCLK: U1.GPIO15 (GPIO15 / AMP BCLK), U7.BCLK
AMP_DIN: U1.GPIO7 (GPIO7 / AMP DIN), U7.DIN
AMP_LRC: U1.GPIO16 (GPIO16 / AMP LRC), U7.LRC
BM_BRAIN_TX: U1.GPIO17 (GPIO17 / UART TX), U2.GPIO14 (GPIO14 / UART RX)
BM_MOTION_TX: U1.GPIO18 (GPIO18 / UART RX), U2.GPIO13 (GPIO13 / UART TX)
EDGE_L_DO: U2.GPIO8 (GPIO8 / EDGE L [P]), U13.DO (DO / EDGE L)
EDGE_R_DO: U2.GPIO9 (GPIO9 / EDGE R [P]), U14.DO (DO / EDGE R)
ENC_L_3V3: U3.P27 (P27 / ENC L [P]), U9.LV1 (LV1 [PLAN])
ENC_L_5V: U9.HV1 (HV1 [PLAN]), U17.OUT
ENC_R_3V3: U3.P28 (P28 / ENC R), U9.LV2
ENC_R_5V: U9.HV2, U10.OUT
GND: J1.- (GND), U1.GND, U2.GND, U3.GND, U4.GND1, U4.GND2, U5.GND1, U5.GND2, U6.GND, U6.LR (L/R = LEFT), U7.GND, U8.GND, U9.GND1, U9.GND2, U10.GND, U11.AD0 (AD0 = 0), U11.GND, U12.GND, U13.GND, U14.GND, U15.IN-, U15.OUT-, U16.IN-, U16.OUT-, U17.GND
L_AO1: M1.1 (+), U4.AO1
L_AO2: M1.2 (-), U4.AO2
L_BO1: M2.1 (+), U4.BO1
L_BO2: M2.2 (-), U4.BO2
L_IN1: U3.P35 (P35 / LEFT IN1), U4.AIN1, U4.BIN1
L_IN2: U3.P40 (P40 / LEFT IN2), U4.AIN2, U4.BIN2
MIC_BCLK: U1.GPIO5 (GPIO5 / MIC BCLK), U6.SCK (SCK/BCLK)
MIC_SD: U1.GPIO6 (GPIO6 / MIC SD), U6.SD
MIC_WS: U1.GPIO4 (GPIO4 / MIC WS), U6.WS
OLED_SCL: U1.GPIO42 (GPIO42 / OLED SCL), U8.SCL
OLED_SDA: U1.GPIO41 (GPIO41 / OLED SDA), U8.SDA
R_AO1: M3.1 (+), U5.AO1
R_AO2: M3.2 (-), U5.AO2
R_BO1: M4.1 (+), U5.BO1
R_BO2: M4.2 (-), U5.BO2
R_IN1: U3.P41 (P41 / RIGHT IN1), U5.AIN1, U5.BIN1
R_IN2: U3.P42 (P42 / RIGHT IN2), U5.AIN2, U5.BIN2
SENSOR_SCL: U2.GPIO12 (GPIO12 / SCL [P]), U11.SCL, U12.SCL
SENSOR_SDA: U2.GPIO11 (GPIO11 / SDA [P]), U11.SDA (SDA / 0x68), U12.SDA (SDA / 0x29)
SPI_CS_N: U2.GPIO5 (GPIO5 / CS_n), U3.P30 (P30 / CS_n)
SPI_MISO: U2.GPIO16 (GPIO16 / MISO), U3.P26 (P26 / MISO)
SPI_MOSI: U2.GPIO15 (GPIO15 / MOSI), U3.P25 (P25 / MOSI)
SPI_SCLK: U2.GPIO4 (GPIO4 / SCLK), U3.P29 (P29 / SCLK)
SPK_N: LS1.2 (SPK-), U7.SPK-
SPK_P: LS1.1 (SPK+), U7.SPK+
STBY_COMMAND: R1.1, R2.1, U2.GPIO10 (GPIO10 / STBY)
STBY_L: R1.2, U4.STBY (STBY/nSLEEP)
STBY_R: R2.2, U5.STBY (STBY/nSLEEP)
VM_8V4: J1.+ (+8.4V), U4.VM, U5.VM, U15.IN+, U16.IN+

Notes on the sheet:
AW-CAR / PROTOTYPE V2 / A3 WIRING
Purple: Brain | Blue: Motion | Green: FPGA | [PLAN]: future wiring, firmware not enabled
RUN: close JP1/2/3 only with board USB unplugged. DEBUG: open that board jumper BEFORE USB.
GPIO17/18 Motion UNUSED. Pxx = PACKAGE pin. System input <=8.4V: VM bypasses the DSN.
DSN 5V: NO-LOAD verified only. AMP buck/load/filters TBD. SPK- is NOT GND.
ENC L: change P27 pull to NONE first. TCRT DO / sensor I2C: 0..3V3. Planned pins not enabled.
