TuanDanny/AW-Car/firmware/brain/main/boards/aw-car-ai-rgb/config.h

#pragma once

#include <driver/gpio.h>

#if !CONFIG_OLED_SSD1306_128X64
#error "AW-Car AI RGB requires SSD1306 128x64"
#endif

#define AUDIO_INPUT_SAMPLE_RATE 16000
#define AUDIO_OUTPUT_SAMPLE_RATE 24000
#define AUDIO_I2S_MIC_GPIO_WS GPIO_NUM_4
#define AUDIO_I2S_MIC_GPIO_SCK GPIO_NUM_5
#define AUDIO_I2S_MIC_GPIO_DIN GPIO_NUM_6
#define AUDIO_I2S_SPK_GPIO_DOUT GPIO_NUM_7
#define AUDIO_I2S_SPK_GPIO_BCLK GPIO_NUM_15
#define AUDIO_I2S_SPK_GPIO_LRCK GPIO_NUM_16

#define BUILTIN_LED_GPIO GPIO_NUM_48
#define BOOT_BUTTON_GPIO GPIO_NUM_0
#define DISPLAY_SDA_PIN GPIO_NUM_41
#define DISPLAY_SCL_PIN GPIO_NUM_42
#define DISPLAY_WIDTH 128
#define DISPLAY_HEIGHT 64
#define DISPLAY_MIRROR_X true
#define DISPLAY_MIRROR_Y true
