TuanDanny/AW-Car/esp/brain/main/device_state.h

#ifndef _DEVICE_STATE_H_
#define _DEVICE_STATE_H_

enum DeviceState {
    kDeviceStateUnknown,
    kDeviceStateStarting,
    kDeviceStateWifiConfiguring,
    kDeviceStateIdle,
    kDeviceStateConnecting,
    kDeviceStateListening,
    kDeviceStateSpeaking,
    kDeviceStateNotifying,
    kDeviceStateUpgrading,
    kDeviceStateActivating,
    kDeviceStateAudioTesting,
    kDeviceStateFatalError
};

#endif // _DEVICE_STATE_H_
