TuanDanny/AW-Car/esp/brain/main/boards/aw-car/sta_network.cc

#include "sta_network.h"
#include "car/runtime.h"
#include <ssid_manager.h>
#include <cJSON.h>
#include <esp_log.h>
#include <esp_timer.h>
#include <esp_wifi.h>
#include <algorithm>
#include <cstring>

namespace {
constexpr uint32_t kUp = 1, kDown = 2;
uint64_t Now() { return esp_timer_get_time()/1000; }
void Disconnect() {
    const auto err=esp_wifi_disconnect();
    if(err!=ESP_OK && err!=ESP_ERR_WIFI_NOT_CONNECT)
        ESP_LOGW("BrainSTA","disconnect failed: %s",esp_err_to_name(err));
}
}
void StaNetwork::Notify(NetworkEvent event, const std::string& data) {
    if (callback_) callback_(event, data);
}
void StaNetwork::Start(NetworkEventCallback callback) {
    callback_ = std::move(callback);
    configurations_ = xQueueCreate(1, sizeof(Credentials));
    ESP_ERROR_CHECK(configurations_ ? ESP_OK : ESP_ERR_NO_MEM);
    ESP_ERROR_CHECK(esp_netif_init());
    auto err = esp_event_loop_create_default();
    ESP_ERROR_CHECK(err == ESP_ERR_INVALID_STATE ? ESP_OK : err);
    netif_ = esp_netif_create_default_wifi_sta();
    ESP_ERROR_CHECK(netif_ ? ESP_OK : ESP_ERR_NO_MEM);
    ESP_ERROR_CHECK(esp_netif_set_hostname(netif_, "AW-Car-Brain"));
    wifi_init_config_t init = WIFI_INIT_CONFIG_DEFAULT();
    ESP_ERROR_CHECK(esp_wifi_init(&init));
    ESP_ERROR_CHECK(esp_wifi_set_storage(WIFI_STORAGE_RAM));
    ESP_ERROR_CHECK(esp_wifi_set_mode(WIFI_MODE_STA));
    ESP_ERROR_CHECK(esp_event_handler_instance_register(WIFI_EVENT, WIFI_EVENT_STA_DISCONNECTED, OnEvent, this, &wifi_handler_));
    ESP_ERROR_CHECK(esp_event_handler_instance_register(IP_EVENT, IP_EVENT_STA_GOT_IP, OnEvent, this, &ip_handler_));
    ESP_ERROR_CHECK(esp_wifi_start());
    ESP_ERROR_CHECK(esp_wifi_set_ps(WIFI_PS_NONE));
    ESP_ERROR_CHECK(xTaskCreate([](void* p) { static_cast<StaNetwork*>(p)->Run(); },
        "brain_sta", 6144, this, 3, &task_) == pdPASS ? ESP_OK : ESP_ERR_NO_MEM);
}
void StaNetwork::OnEvent(void* arg, esp_event_base_t base, int32_t id, void* data) {
    auto* self = static_cast<StaNetwork*>(arg);
    if (base == IP_EVENT && id == IP_EVENT_STA_GOT_IP) {
        const auto* event = static_cast<ip_event_got_ip_t*>(data);
        {
            std::lock_guard lock(self->state_mutex_);
            std::memcpy(self->ip_.data(), &event->ip_info.ip.addr, 4);
        }
        self->connected_ = true;
        self->result_ = 2;
        if (self->task_) xTaskNotify(self->task_, kUp, eSetBits);
    } else {
        self->connected_ = false;
        brain::Runtime::Get().SetCloud(false);
        if (self->task_) xTaskNotify(self->task_, kDown, eSetBits);
    }
}
bool StaNetwork::Configure(const simple::Frame& frame) {
    if (frame.size < 3) return false;
    const auto ss = frame.payload[0], pw = frame.payload[1];
    if (ss < 1 || ss > 32 || pw > 64 || frame.size != 2+ss+pw ||
        std::memchr(frame.payload.data()+2, 0, ss+pw)) return false;
    Credentials credentials;
    credentials.ssid_len = ss; credentials.pass_len = pw;
    std::memcpy(credentials.ssid, frame.payload.data()+2, ss);
    std::memcpy(credentials.password, frame.payload.data()+2+ss, pw);
    result_ = 1;
    const bool queued = xQueueOverwrite(configurations_, &credentials) == pdPASS;
    explicit_bzero(&credentials, sizeof(credentials));
    return queued;
}
void StaNetwork::FillState(simple::BrainState& state) {
    state.wifi_result = result_;
    {
        std::lock_guard lock(state_mutex_);
        std::memcpy(state.ssid.data(), ssid_.data(), std::min(ssid_.size(), state.ssid.size()));
        if (connected_) { state.flags |= simple::kWifiReady; state.ipv4 = ip_; }
    }
    wifi_ap_record_t ap{};
    if (connected_ && esp_wifi_sta_get_ap_info(&ap) == ESP_OK) state.rssi = ap.rssi;
}
std::string StaNetwork::Json() {
    simple::BrainState state;
    FillState(state);
    char ip[16];
    snprintf(ip, sizeof(ip), "%u.%u.%u.%u", state.ipv4[0],state.ipv4[1],state.ipv4[2],state.ipv4[3]);
    auto* json = cJSON_CreateObject();
    cJSON_AddStringToObject(json, "type", "wifi");
    cJSON_AddStringToObject(json, "name", "aw-car-simplev1");
    cJSON_AddStringToObject(json, "ssid", std::string(state.ssid.data(), strnlen(state.ssid.data(),32)).c_str());
    cJSON_AddStringToObject(json, "ip", ip);
    cJSON_AddNumberToObject(json, "rssi", state.rssi);
    char* encoded = cJSON_PrintUnformatted(json);
    std::string result = encoded ? encoded : "{}";
    cJSON_free(encoded); cJSON_Delete(json);
    return result;
}
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
