TuanDanny/AW-Car/fpga/rtl/spi32.sv

`timescale 1ns/1ps
`default_nettype none
// Oversampled mode-0 slave. Every register uses clk; SCLK is data, never a clock.
module spi32 (
    input wire logic clk, rst_n,
    input wire logic cs_n, sclk, mosi,
    input wire logic [7:0] status_flags,
    input wire logic [15:0] applied_seq,
    input wire logic [31:0] left_count, right_count,
    input wire logic [31:0] left_period, right_period, left_age, right_age,
    output logic miso,
    output logic command_valid,
    output logic [15:0] command_seq,
    output logic signed [15:0] command_left, command_right
);
    (* syn_keep = 1 *) logic cs_meta, cs_sync;
    (* syn_keep = 1 *) logic sclk_meta, sclk_sync;
    (* syn_keep = 1 *) logic mosi_meta, mosi_sync;
    logic cs_previous, sclk_previous, active;
    logic [8:0] bit_count;
    logic overflow, bad_frame;
    logic [7:0] rx_shift;
    logic [15:0] rx_crc, received_crc, rx_seq;
    logic signed [15:0] rx_left, rx_right;
    // Byte 0 occupies [239:232]. The frozen record shifts only on SCLK falls.
    logic [239:0] sr32;
    logic [15:0] tx_crc;
    wire logic cs_fall = cs_previous && !cs_sync;
    wire logic cs_rise = !cs_previous && cs_sync;
    wire logic sclk_rise = !sclk_previous && sclk_sync;
    wire logic sclk_fall = sclk_previous && !sclk_sync;
    wire logic [7:0] rx_byte = {rx_shift[6:0], mosi_sync};

    function automatic logic [15:0] crc_bit(input logic [15:0] crc, input logic bit_in);
        crc_bit = {crc[14:0], 1'b0} ^ ((crc[15] ^ bit_in) ? 16'h1021 : 16'h0000);
    endfunction
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
