TuanDanny/AW-Car/(commit log)

2026-10-23 chore: initialize AW-Car skeleton and FPGA project plan (#2)
    Set up repository structure, workflow rules, local hooks and CI. Record the approved two-ESP32-S3, FPGA and one-microphone architecture. RTL design and verification remain the next implementation phase.
2026-10-23 feat: decode dual encoders and capture coherent snapshots (#4)
2026-10-23 feat: add atomic dual PWM and direction interlock (#5)
    * feat: add atomic dual PWM and driver-neutral direction interlock
    * fix: resolve Windows simulator paths and child DLL environment
2026-10-23 feat: add FPGA UART protocol and command guard (#7)
2026-10-24 feat: reduce FPGA duty registers and share safety timers (#10)
2026-10-24 test(fpga): mở rộng regression và lưu bằng chứng module (#11)
2026-11-05 Brain: Dashboard Manual/AI, AP+STA và WS2812 báo trạng thái (#13)
    User-approved milestone 0.1, Brain first. Source fe776f0; reviewed together with Motion bc27255 as integration a27a098 (all five CI jobs passed). Preserve driver LOCKED and hardware-not-verified limits. Motion and integration resolutions follow via PR #14; no device flashing.
2026-11-05 Motion: chốt baseline Brain+Motion LOCKED sau tích hợp main (#14)
    Integrate Motion after Brain squash e781c6b using the reviewed a27a098 resolution and CI baseline. Preserve BM-v1, FPGA v2 peer contract, UART pin mapping and driver LOCKED defaults. Runtime/config/test/workflow tree matches the approved candidate; update release metadata only.
    Validated: PR checks 41964518117 and 41964518142, plus Brain post-merge main check 41963788101. Final main CI must succeed before v0.1-brain-motion-locked tag.
    Hardware not verified for integrated binaries. No flash, reset, NVS change, driver enable, or FPGA development merge.
2026-11-10 feat(simplev1): host control on Motion with SPI FPGA and AI Brain
2026-11-10 docs(simplev1): record FPGA Flash and live SPI verification
2026-11-10 test(simplev1): synchronize key trace and record DRV measurements
2026-11-10 chore: establish accepted simplev1 as prototype v1 baseline
2026-11-10 Promote accepted simplev1 AP+STA/OTA and smooth Manual/AI prototype (#15)
    Preserve AP-only driving, add pinned management/OTA, fix held-input backpressure and default AI to 3s. Include 92 real-phone timing samples and explicitly retain unresolved SPI frame/ACK and physical PWM/motor validation limits. PR CI passed; rerun CI on main.
2026-11-10 Prototype v2: stable main skeleton and measured Web optimizations (#17)
    Keep the accepted Web/Motion/SPI/FPGA flow, reduce redundant DOM work and defer STA retry during motion intent. Preserve Brain/FPGA source and all control timing contracts. Record real-phone A60/B61 measurements and remaining limits. Owner approved main as the sole official branch; tag and clean feature branches only after post-merge main CI succeeds.
2026-11-11 docs: redraw A3 module wiring with colored boards and planned sensors
2026-11-11 fix: keep schematic verification paths and text portable
